robertying/cpu/README.md

# 32 位 MIPS 处理器设计

- 32 位 ALU
- 单周期 MIPS 处理器
- 5 级流水线 MIPS 处理器

单周期处理器设计图

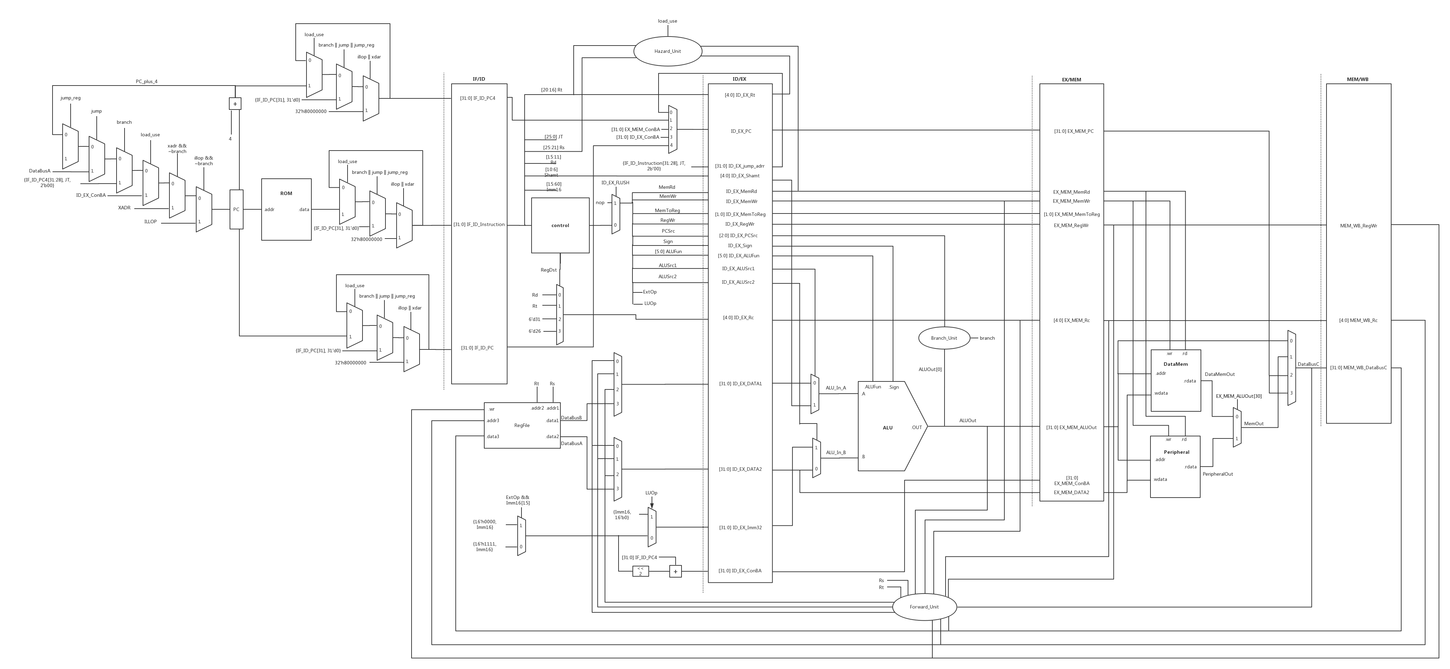
[picture p1: PipelineCPU.png]
流水线处理器设计图
