robertying/cpu/EGo1.xdc

# sysclk
set_property -dict {PACKAGE_PIN P17 IOSTANDARD LVCMOS33} [get_ports sysclk]
create_clock -period 8.280 -name CLK -waveform {0.000 4.140} [get_ports sysclk]
#create_clock -period 16.000 -name CLK -waveform {0.000 10.000} [get_ports sysclk]

# reset
set_property -dict {PACKAGE_PIN R1 IOSTANDARD LVCMOS33} [get_ports reset]

# UART
set_property -dict {PACKAGE_PIN N5 IOSTANDARD LVCMOS33} [get_ports UART_RX]
set_property -dict {PACKAGE_PIN T4 IOSTANDARD LVCMOS33} [get_ports UART_TX]

# digital tube
set_property -dict {PACKAGE_PIN B4 IOSTANDARD LVCMOS33} [get_ports {digi[0]}]
set_property -dict {PACKAGE_PIN A4 IOSTANDARD LVCMOS33} [get_ports {digi[1]}]
set_property -dict {PACKAGE_PIN A3 IOSTANDARD LVCMOS33} [get_ports {digi[2]}]
set_property -dict {PACKAGE_PIN B1 IOSTANDARD LVCMOS33} [get_ports {digi[3]}]
set_property -dict {PACKAGE_PIN A1 IOSTANDARD LVCMOS33} [get_ports {digi[4]}]
set_property -dict {PACKAGE_PIN B3 IOSTANDARD LVCMOS33} [get_ports {digi[5]}]
set_property -dict {PACKAGE_PIN B2 IOSTANDARD LVCMOS33} [get_ports {digi[6]}]
set_property -dict {PACKAGE_PIN D5 IOSTANDARD LVCMOS33} [get_ports {digi[7]}]

# enable signal for specific digital tube
set_property -dict {PACKAGE_PIN C2 IOSTANDARD LVCMOS33} [get_ports {digi[11]}]
set_property -dict {PACKAGE_PIN G2 IOSTANDARD LVCMOS33} [get_ports {digi[10]}]
set_property -dict {PACKAGE_PIN H1 IOSTANDARD LVCMOS33} [get_ports {digi[9]}]
set_property -dict {PACKAGE_PIN C1 IOSTANDARD LVCMOS33} [get_ports {digi[8]}]

# led
set_property -dict {PACKAGE_PIN K2 IOSTANDARD LVCMOS33} [get_ports {led[0]}]
set_property -dict {PACKAGE_PIN J2 IOSTANDARD LVCMOS33} [get_ports {led[1]}]
set_property -dict {PACKAGE_PIN J3 IOSTANDARD LVCMOS33} [get_ports {led[2]}]
set_property -dict {PACKAGE_PIN H4 IOSTANDARD LVCMOS33} [get_ports {led[3]}]
set_property -dict {PACKAGE_PIN J4 IOSTANDARD LVCMOS33} [get_ports {led[4]}]
set_property -dict {PACKAGE_PIN G3 IOSTANDARD LVCMOS33} [get_ports {led[5]}]
set_property -dict {PACKAGE_PIN G4 IOSTANDARD LVCMOS33} [get_ports {led[6]}]
set_property -dict {PACKAGE_PIN F6 IOSTANDARD LVCMOS33} [get_ports {led[7]}]

# switch
set_property -dict {PACKAGE_PIN T5 IOSTANDARD LVCMOS33} [get_ports {switch[0]}]
set_property -dict {PACKAGE_PIN T3 IOSTANDARD LVCMOS33} [get_ports {switch[1]}]
set_property -dict {PACKAGE_PIN R3 IOSTANDARD LVCMOS33} [get_ports {switch[2]}]
set_property -dict {PACKAGE_PIN V4 IOSTANDARD LVCMOS33} [get_ports {switch[3]}]
set_property -dict {PACKAGE_PIN V5 IOSTANDARD LVCMOS33} [get_ports {switch[4]}]
set_property -dict {PACKAGE_PIN V2 IOSTANDARD LVCMOS33} [get_ports {switch[5]}]
set_property -dict {PACKAGE_PIN U2 IOSTANDARD LVCMOS33} [get_ports {switch[6]}]
set_property -dict {PACKAGE_PIN U3 IOSTANDARD LVCMOS33} [get_ports {switch[7]}]
