robertying/cpu/DataMem.v

module DataMem (reset, clk, rd, wr, addr, wdata, rdata);
input reset, clk;
input rd, wr;
input [31:0] addr;	//Address Must be Word Aligned
output [31:0] rdata;
input [31:0] wdata;

parameter RAM_SIZE = 256;
(* ram_style = "distributed" *) reg [31:0] RAMDATA [RAM_SIZE-1:0];

assign rdata = (rd && (addr < 4 * RAM_SIZE)) ? RAMDATA[addr[31:2]] : 32'b0;

always@(posedge clk) begin
	if(wr && (addr < 4 * RAM_SIZE)) RAMDATA[addr[31:2]] <= wdata;
end

endmodule
