robertying/cpu/SingleCycleCPU_tb.v

`timescale 1ns/1ps

module SingleCycleCPU_tb;

reg sysclk;
reg reset;
reg UART_RX;

wire [7:0] led;
wire [7:0] switch;
wire [11:0] digi;
wire UART_TX;

initial begin
	sysclk <= 0;
	reset <= 1;
	UART_RX <= 1;

	#10 reset <= 0;
	#10 reset <= 1;

	// first number = 84
	#104167 UART_RX = 0;
    #104167 UART_RX = 0;
    #104167 UART_RX = 0;
    #104167 UART_RX = 1;
    #104167 UART_RX = 0;
    #104167 UART_RX = 1;
    #104167 UART_RX = 0;
    #104167 UART_RX = 1;
    #104167 UART_RX = 0;
    #104167 UART_RX = 1;

	// second number = 12
	#104167 UART_RX = 0;
    #104167 UART_RX = 0;
    #104167 UART_RX = 0;
    #104167 UART_RX = 1;
    #104167 UART_RX = 1;
    #104167 UART_RX = 0;
    #104167 UART_RX = 0;
    #104167 UART_RX = 0;
    #104167 UART_RX = 0;
    #104167 UART_RX = 1;
end

always #5 sysclk = ~sysclk;

SingleCycleCPU SingleCycleCPU_test(.reset(reset), .sysclk(sysclk),
								   .led(led), .switch(switch), .digi(digi),
								   .UART_RX(UART_RX), .UART_TX(UART_TX));

endmodule
