robertying/cpu/(commit log)

2018-07-12 Add uart & peripheral
2018-07-12 Add digital tube display
2018-07-12 new gcd assembly
2018-07-12 Add uart testbench
2018-07-12 Fix peripheral & uart to pass simulation
2018-07-13 Remove rx_enable in uart
2018-07-13 assembly with notes
2018-07-13 UART update
2018-07-13 fix BCD code of 1
    [gcd.asm]
2018-07-13 add config of switch, led, RX, TX
2018-07-13 upload assembler
2018-07-14 new mips without uart
2018-07-14 Fix uart clk division
2018-07-14 change uart freq
2018-07-15 Use 100M sysclk for uart clk division & add reset for led
    [Peripheral.v, SingleCycleCPU.v]
2018-07-15 change name and switch
2018-07-17 plan B passed the test without UART
2018-07-17 Fix switch input & improve slack time
    [Peripheral.v]
